Team-Resurgent/Xtremium/Hardware/bom.csv

Reference | Qty | Description | Part Number | Manufacturer | Digikey
U1 | 1 | IC FPGA 68 I/O 100VQFP | XC3S50A-4VQG100C | Xilinx Inc. | 122-1592-ND
U2,U3,U4 | 3 | IC FLASH 128MBIT SPI/QUAD 8SOIC | W25Q128JVSIQ | Winbond Electronics Corp | W25Q128JVSIQ-ND
U5 | 1 | IC REG LINEAR 1.2V 300MA 5TSOP | NCV8164ASN120T1G | ON Semiconductor Corp | 488-NCV8164ASN120T1GCT-ND
LED1 | 1 | LED RGB CLEAR 4SMD. COMMON ANODE | 19-237/R6GHBHC-A07/2T | Everlight Electronics Co Ltd | 1080-1590-1-ND
C1,C2 | 2 | CAP CER 0.1UF 50V 0603 | CL10B104KB8NNNC | Capacitor Generic | 1276-1000-1-ND
C3,C5 | 2 | CAP CER 1UF 25V X5R 0603 | CL10A105KA8NNNC | Capacitor Generic | 1276-1102-1-ND
C4 | 1 | CAP CER 10UF 6.3V 0603 | JMK107ABJ106MA-T | Capacitor Generic | 587-5869-1-ND
R1,R2,R3 | 3 | RES 470 OHM 1% 1/10W 0603 | RC0603FR-07470RL | Resistor Generic | 311-470HRCT-ND
R4,R5,R6,R7,R8,R9 | 6 | RES 10K OHM 5% 1/10W 0603 | RMCF0603JT10K0 | Resistor Generic | RMCF0603JT10K0CT-ND
RN1 | 1 | RES ARRAY 4 RES 10K OHM 1206 | EXB-38V103JV | Resistor Array Generic | Y9103CT-ND
Q1,Q2,Q3,Q4,Q5 | 5 | MOSFET N-CH 20V 4.1A SOT-23 | IRLML6246TRPBF | Infineon Technologies | IRLML6246TRPBFCT-ND
LPC | 1 | Female Pin Header | PPTC072LFBN-RC | Female Pin Header Generic 2x7 0.1in | S7075-ND
J1 | 1 | 1.0MM WTB RIGHT ANGLE TYPE WITH | 1-2367196-0 | TE Connectivity | 17-1-2367196-0CT-ND
J1 | 1 | 1.0 WTB HOUSING WITH LATCH | 1-2367198-0 | TE Connectivity | 17-1-2367198-0-ND
J2 | 1 | PICO-LOCK 1.0 W/B HEADER ASSY ET | 503763-0591 | Molex | 2266-503763-0591TR-ND
J2 | 1 | CONN RCPT HSG 5POS 1.00MM | 503764-0501 | Molex | WM25684-ND
J1,J2 | 15 | CONN SOCKET 28-30AWG CRIMP GOLD | 503765-0098 | Molex | WM10651CT-ND
D0,A20M# | 1 | CONN HEADER R/A 2POS 2.54MM | M20-9960245 | Harwin | 952-2244-ND
D0,A20M# | 1 | CONN RCPT HSG 2POS 2.54MM | M20-1060200 | Harwin | 952-2227-ND
D0,A20M# | 2 | CONN SOCKET 22-30AWG CRIMP GOLD | M20-1160042 | Harwin | 952-2157-1-ND
