Team-Resurgent/Xtremium/Hardware/openxenium-qpi.kicad_pcb

## KiCad design Hardware/openxenium-qpi.kicad_pcb (2023-03-06)

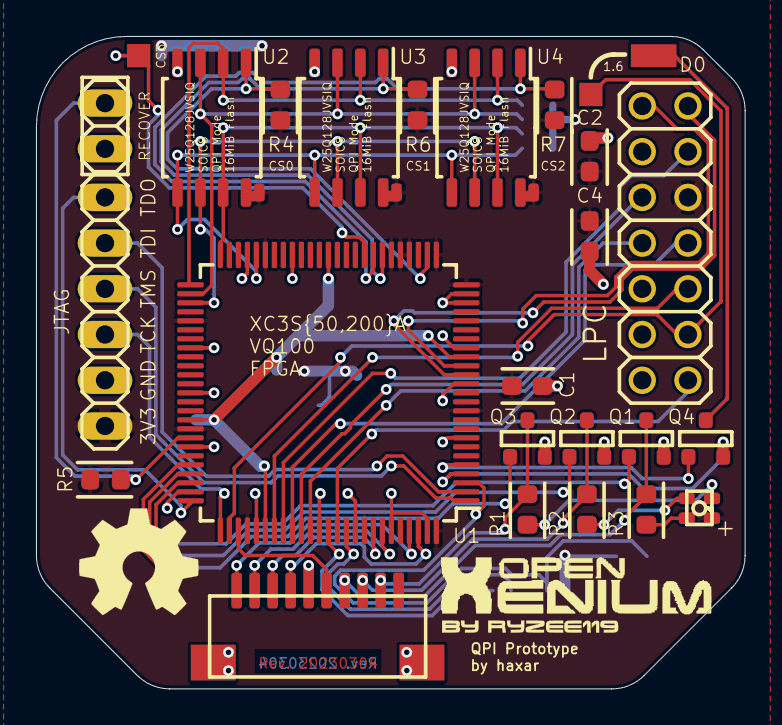
[picture p1: board openxenium-qpi.kicad_pcb from above]

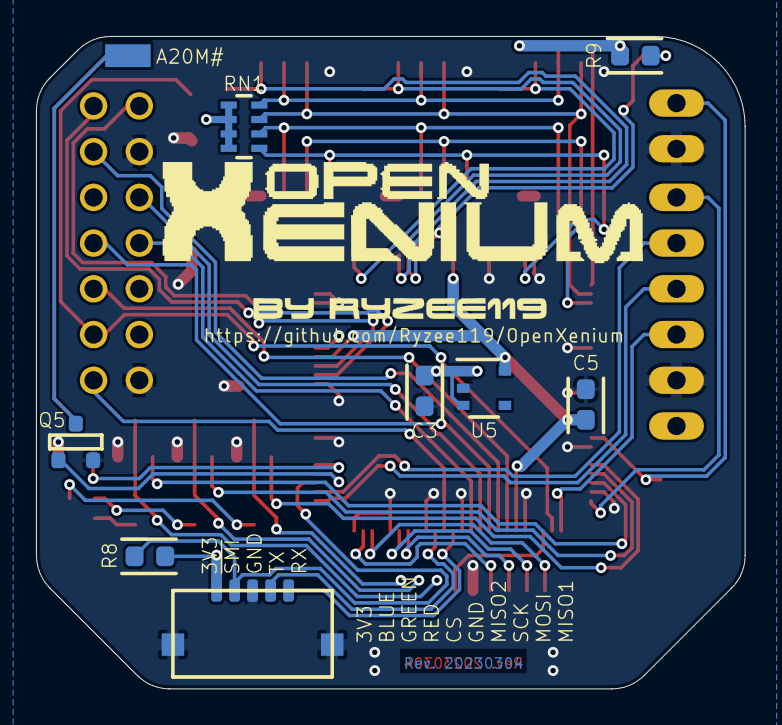
[picture p2: board openxenium-qpi.kicad_pcb from below]

Board: 2 copper layers, 39.4 x 36.2 mm, 39 parts (9 on the bottom side), 47 nets.

Parts:
A20M#: SMD1,27-2,54
C1, C2: 0.1uF; C0603
C3, C5: 1uF; C0603
C4: 10uF; C0603
D0: SMD1,27-2,54
J1: TE Connectivity 1-2367196-0; SM10B-SRSS-TB
J2: Molex 503763-0591; SM10B-SRSS-TB
JTAG: 1X06
L1: 19-237/R6GHBHC-A07/2T; 4-SMD-R6GHBHC
LPC: 2X07
OSHW Logo: OSHW-Symbol_6.7x6mm_SilkScreen
Q1, Q2, Q3, Q4, Q5: SOT-23
R1, R2, R3: 470; R0603
R4, R5, R6, R7, R8, R9: 10k; R0603
RECOVERY: 1X02
RN1: 10k; R_Array_Concave_4x0603
TP1, TP2: TPTP13SQ; TP13SQ
U1: VQFP-100_14x14mm_P0.5mm
U2, U3, U4: SOIC-8_5.23x5.23mm_P1.27mm
U5: onsemi NCV8164ASN120T1G; TSOP-5_1.65x3.05mm_P0.95mm
VCC1, VCC2, VCC3: SMD-Pad_0.6x1mm

Connections:
+1V2: C5.2, U1.17, U1.38, U1.66, U1.81, U5.5
+3V3: C1.1, C2.1, C3.1, C4.1, J1.10, J2.1, JTAG.1, L1.VCC, LPC.9, R4.1, R5.1, R6.1, R7.1, R8.2, R9.1, RN1.1, RN1.2, RN1.3, RN1.4, U1.11, U1.22, U1.25, U1.26, U1.29, U1.30, U1.31, U1.45, U1.55, U1.67, U1.79, U1.92, U1.96, U1.100, U2.8, U3.8, U4.8, U5.1, U5.3, VCC1.1, VCC2.1, VCC3.1
FTDI_RXD: J2.4, U1.90
FTDI_TXD: J2.5, U1.88
GND: C1.2, C2.2, C3.2, C4.2, C5.1, J1.5, J1.C1, J1.C2, J2.3, J2.C1, J2.C2, JTAG.2, LPC.2, LPC.12, Q1.2, Q2.2, Q3.2, Q4.2, Q5.2, RECOVERY.1, U1.8, U1.14, U1.18, U1.23, U1.24, U1.42, U1.47, U1.58, U1.63, U1.69, U1.74, U1.80, U1.87, U1.91, U1.95, U1.99, U2.4, U3.4, U4.4, U5.2
HEADER_CS: J1.6, U1.78
HEADER_LED_B: J1.9, Q3.1, R1.2
HEADER_LED_G: J1.8, Q2.1, R2.2
HEADER_LED_R: J1.7, Q1.1, R3.2
HEADER_MISO1: J1.1, U1.97
HEADER_MISO2: J1.4, U1.98
HEADER_MOSI: J1.2, U1.94
HEADER_SCK: J1.3, U1.93
LED_B: L1.B, R1.1
LED_G: L1.G, R2.1
LED_R: L1.R, R3.1
LPC_CLK: LPC.1, U1.89
LPC_LAD0: LPC.11, U1.83
LPC_LAD1: LPC.10, U1.85
LPC_LAD2: LPC.8, U1.86
LPC_LAD3: LPC.7, U1.84
LPC_LFRAME: LPC.3, TP1.TP, U1.77
LPC_RST: LPC.5, U1.82
MOSFET_A20M: Q5.3, U1.4
MOSFET_D0: Q4.3, U1.5
MOSFET_LED_B: Q3.3, U1.71
MOSFET_LED_G: Q2.3, U1.72
MOSFET_LED_R: Q1.3, U1.73
PAD_A20M: A20M#.1, Q5.1
PAD_D0: D0.1, Q4.1
QPI_CLK: U1.53, U2.6, U3.6, U4.6
QPI_CS0: R4.2, U1.27, U2.1
QPI_CS1: R6.2, U1.32, U3.1
QPI_CS2: R7.2, U1.33, U4.1
QPI_CS3: R9.2, TP2.TP, U1.34
QPI_IO0: RN1.5, U1.46, U2.5, U3.5, U4.5
QPI_IO1: RN1.8, U1.51, U2.2, U3.2, U4.2
QPI_IO2: RN1.7, U1.52, U2.3, U3.3, U4.3
QPI_IO3: RN1.6, U1.50, U2.7, U3.7, U4.7
SCL: LPC.13, U1.15
SDA: LPC.14, U1.16
SWITCH_RECOVER: R5.2, RECOVERY.2, U1.68
TCK: JTAG.3, U1.76
TDI: JTAG.5, U1.2
TDO: JTAG.6, U1.75
TMS: JTAG.4, U1.1
~SMI: J2.2, R8.1, U1.3
