Team-Resurgent/Xtremium/(commit log)

2022-04-14 FW: Overlay LPC bus activity on the LED
2022-04-14 FW: Reduce syncing stage wait states for IO transactions
2022-04-27 FW: Implement bank & chip selection
    [bom.csv]
2022-04-27 FW: nit: Decrease indent for case statements (same for C style switch)
2022-05-04 FW: Check busy bit when switching chips
2022-05-07 After building, testing & realizing the chips don't power-up in QPI mode & design needs a Spartan-3E instead
2022-05-12 FW: Initialize QPI mode for all chips at power-up
2022-05-13 HW: Update BOM
    [bom.csv]
2022-05-30 FW: Finally fix Read Status Register-1 & Page Program (delay logic did nothing)
    [openxenium.vhd]
2022-06-01 FW: Ensure QPI mode is set at power-up
    [bom.csv]
2022-06-07 FW: Prevent edge case of overwriting IO registers when determining LPC cycle type
    [openxenium.vhd]
2022-06-25 FW: Prevent race condition by adding stop state for end sector erase logic
    [openxenium.vhd]
2022-07-05 HW: Import Rev. 20220704 QPI board
    [openxenium-qpi.kicad_pcb, openxenium-qpi.kicad_sch]
2022-07-24 HW: Include wire housings & contacts in BOM
    [bom.csv]
2022-07-24 HW: Include right-angle header for D0 & A20M# in BOM
    [bom.csv]
2022-07-27 HW: nit: Consolidate edge cut line breaks
    [openxenium-qpi.kicad_pcb]
2023-03-06 FW: Refactor & assign `CS3` QPI auxiliary chip select signal
    [bom.csv]
2023-03-06 FW: Rearrange FPGA pins 3,4,5 (breaks compat with Rev. 20220704 QPI board)
2023-03-06 HW: Import Rev. 20230304 QPI board
    [openxenium-qpi.kicad_pcb, openxenium-qpi.kicad_sch]
2023-03-08 FW: Preliminary UART TX support (to FTDI at 3Mbps via 96MHz DCM)
2023-03-09 FW: Fix LPC bus master arbitration when detecting SuperIO
    [openxenium.vhd]
2023-03-11 FW: Add UART Scratch Register
2023-03-11 FW: Show UART TX activity on green LED
2023-03-13 FW: nit: Shorten signal names
    [openxenium.vhd]
2023-03-13 FW: Correct DCM output clock period from 96.96MHz to 96MHz
    [openxenium.vhd]
2023-03-25 FW: Prevent bank/chip selection when in a SDP state
    [openxenium.vhd]
2023-05-10 FW: Fix UART TX corruption edge case
    [openxenium.vhd, uart_tx.vhd]
2023-05-10 FW: Fix UART TX duplication edge case
    [uart_tx.vhd]
2023-05-11 FW: Fix another UART TX duplication edge case
    [uart_tx.vhd]
2023-05-12 FW: Fix UART TX to one stop bit (saturation speedup by 33KiB/s; was right the first time)
    [uart_tx.vhd]
