Team-Resurgent/Xtremium/(notices)

Notices in the files:
Hardware/openxenium-qpi.kicad_pcb:
Licensed under CERN OHL v.1.2 or later
